shigobu/PjdController/(commit log)

2022-06-09 シングルタッチ完成
2022-06-09 arduino pico 2.0.3 に対応
2022-06-11 xinputファイル削除
2022-06-11 HID対応
2022-06-11 環境構築を記述
2022-06-11 使用パーツの追加
2022-06-11 プルアップを使用するように変更
2022-06-11 配線の説明追加
2022-06-11 使用パーツ追記
2022-06-11 遅延について追記
2022-06-11 配線の追記
2022-06-11 タッチセンサの配線追記
2022-06-12 配線図の追加
2022-06-12 スライド同時押し未対応について追記
